RobertWojtowicz/roomba/pcb/roomba_led_pcb_v1.brd

## EAGLE design pcb/roomba_led_pcb_v1.brd (2021-01-24)

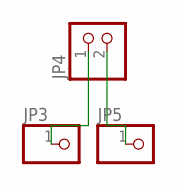
[picture p12: schematic roomba_led_pcb_v1.sch]

Parts:
JP3, JP5: PINHD-1X1; 1X01
JP4: PINHD-1X2/90; 1X02/90

Connections:
unnamed: JP3.1, JP4.1
unnamed: JP4.2, JP5.1

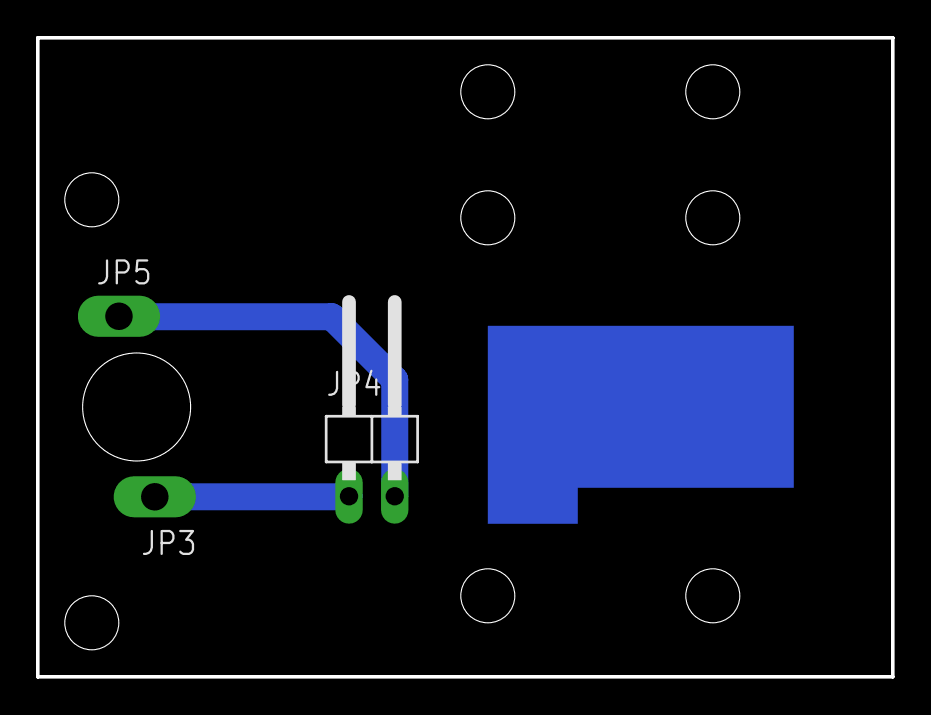
[picture p13: board roomba_led_pcb_v1.brd from above]

Board: 2 copper layers, 47.5 x 35.5 mm, 3 parts (0 on the bottom side), 2 nets.
