RobertWojtowicz/roomba/pcb/roomba_main_pcb_v1.brd

## EAGLE design pcb/roomba_main_pcb_v1.brd (2021-01-24)

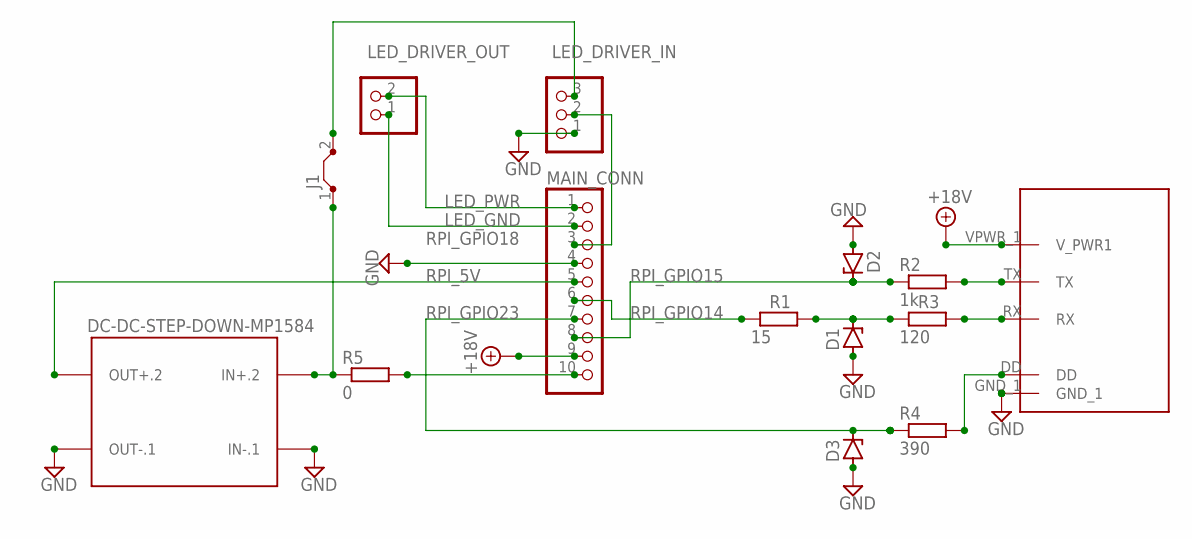
[picture p14: schematic roomba_main_pcb_v1.sch]

Parts:
D1, D2, D3: ZENER-DIODESOD80C; SOD80C
J1: J25MM; 25
LED_DRIVER_IN: PINHD-1X3; 1X03
LED_DRIVER_OUT: PINHD-1X2; 1X02
MAIN_CONN: PINHD-1X10/90; 1X10/90
R1: 15; M1206
R2: 1k; M1206
R3: 120; M1206
R4: 390; M1206
R5: 0; M1206
ROOMBA_PORT: 7_PIN; PIN-7
U$1: DC-DC-STEP-DOWN-MP1584

Connections:
+18V: MAIN_CONN.9, ROOMBA_PORT.VPWR_1 (V_PWR1)
GND: D1.A, D2.A, D3.A, LED_DRIVER_IN.1, MAIN_CONN.4, ROOMBA_PORT.GND_1, U$1.IN-.1, U$1.OUT-.1
LED_GND: LED_DRIVER_OUT.1, MAIN_CONN.2
LED_PWR: LED_DRIVER_OUT.2, MAIN_CONN.1
unnamed: J1.1, R5.1, U$1.IN+.2
unnamed: R4.2, ROOMBA_PORT.DD
unnamed: J1.2, LED_DRIVER_IN.3
unnamed: R3.2, ROOMBA_PORT.RX
unnamed: D1.C, R1.2, R3.1
unnamed: R2.2, ROOMBA_PORT.TX
unnamed: MAIN_CONN.10, R5.2
RPI_5V: MAIN_CONN.5, U$1.OUT+.2
RPI_GPIO14: MAIN_CONN.6, R1.1
RPI_GPIO15: D2.C, MAIN_CONN.8, R2.1
RPI_GPIO18: LED_DRIVER_IN.2, MAIN_CONN.3
RPI_GPIO23: D3.C, MAIN_CONN.7, R4.1

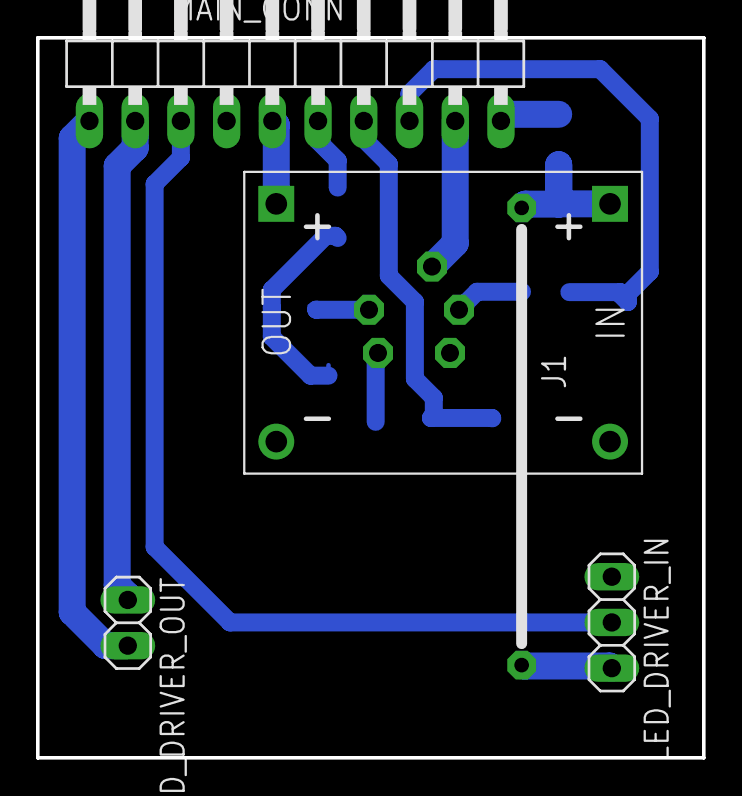
[picture p15: board roomba_main_pcb_v1.brd from above]

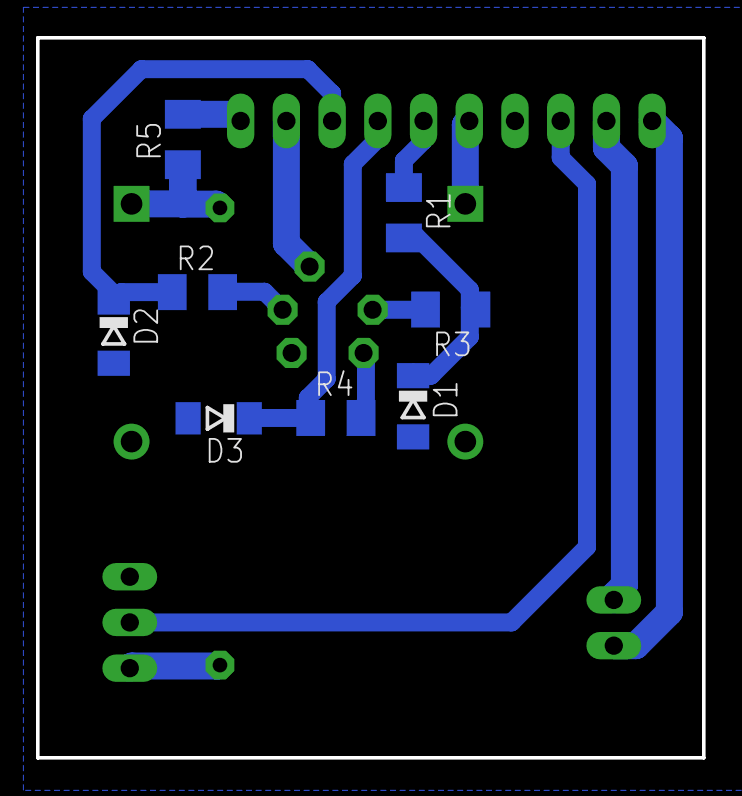
[picture p16: board roomba_main_pcb_v1.brd from below]

Board: 2 copper layers, 37.0 x 40.0 mm, 14 parts (8 on the bottom side), 16 nets.
