RobertWojtowicz/roomba/rpi/boot/config.txt

# *********
# RPiRoomba v1.0
# *********

# Disable optional hardware interfaces
dtparam=i2c_arm=off
dtparam=i2s=off
dtparam=spi=off
dtparam=audio=off

# Other
enable_uart=1
start_x=1
gpu_mem=128
disable_camera_led=1

# Disable the ACT LED on the Pi Zero
dtparam=act_led_trigger=none
dtparam=act_led_activelow=on

# Disable bluetooth on the Pi Zero
dtoverlay=pi3-disable-bt

# Switch off IR LED on boot
gpio=18=op,dl
